Dx724/Lightfield/Artwork/Figure_1_mona_lisa.png

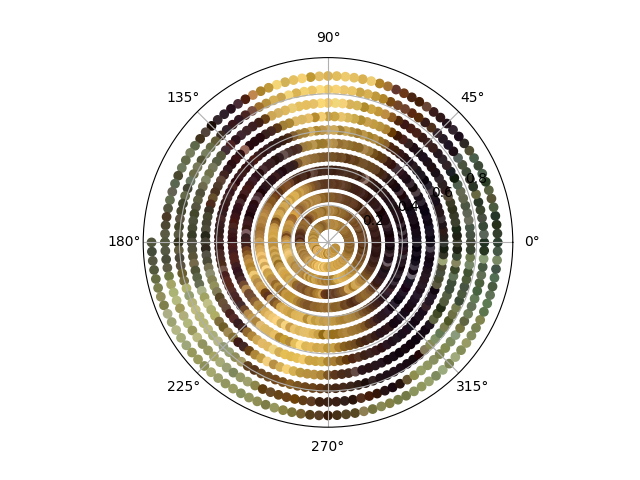
Artwork/Figure_1_mona_lisa.png
