Dx724/Lightfield/Artwork/mona_lisa.png

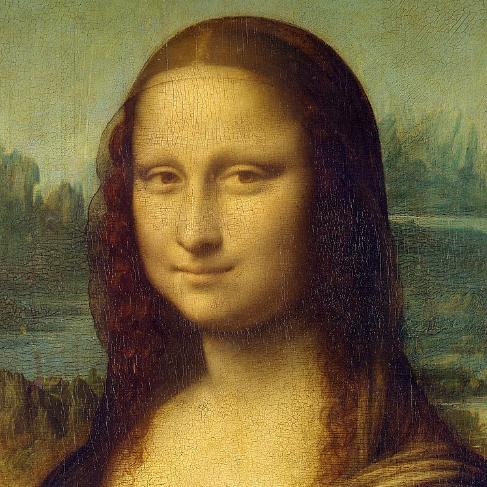
Artwork/mona_lisa.png
