Dx724/Lightfield/Artwork/The-Starry-Night.jpg

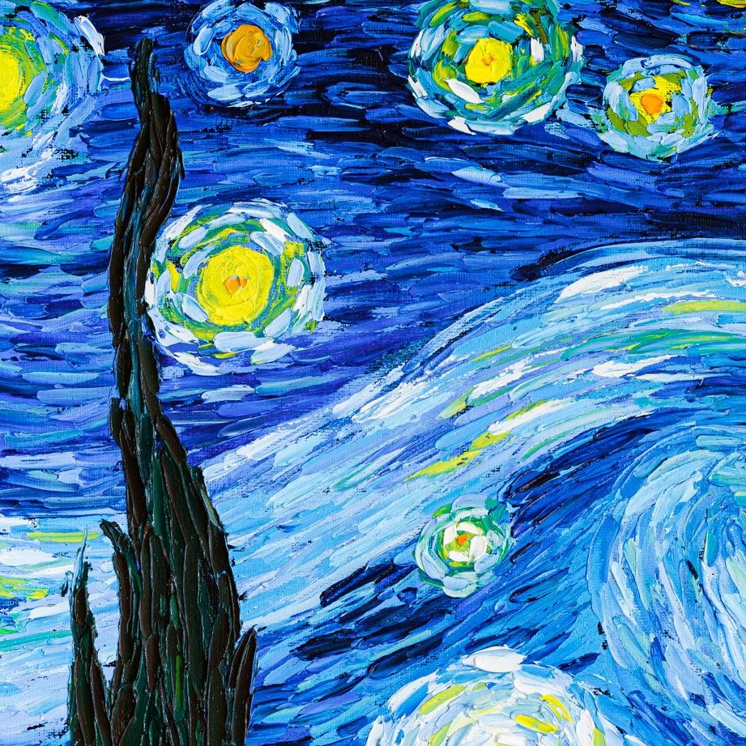
Artwork/The-Starry-Night.jpg
