Dx724/Lightfield/ESP32/Lightfield_MonaLisa.ino

#include <Stepper.h>
#include <ESP32Servo.h>

const int stepsPerRevolution = 2038;

Stepper stepper = Stepper(stepsPerRevolution, 14, 26, 27, 25);
int currentRotation = 0;

Servo servo;
const int SERVO_OFFSET = 0; // Extra degrees past 180 to point straight back to center (should be a negative or zero quantity)

const int ledPins[] = {33, 32, 2}; // R, G, B
const int pwmCh[] = {5, 6, 7};
int red = 255;
int green = 0;
int blue = 255;

double r1 = 8.89; // cm
double r2 = 9.85; // cm
double maxrad = r1 + r2 - 0.1; // cm (small tolerance provided)

void setup() {
  Serial.begin(9600);
  stepper.setSpeed(10);

  for (int i = 0; i < 3; i++) {
    ledcSetup(pwmCh[i], 1000, 8);
    ledcAttachPin(ledPins[i], pwmCh[i]);
  }

  servo.setPeriodHertz(50);
  servo.attach(15, 500, 2500); // This will find an unused PWM channel to attach to

  do_artwork();
}

void stepper_move(int steps) {
  currentRotation += steps;
  stepper.step(steps);
}

void stepper_to_angle(double angle) { // Calculated with acos, so should remain bounded
  stepper_move((int) (stepsPerRevolution*(angle/360.0) - currentRotation));
}

void combo_move(double th1, double th2) {
  stepper_to_angle(th1);
  servo.write((int) th2);
}

void setColor(byte r, byte g, byte b) {
  ledcWrite(pwmCh[0], 255 - r);
  ledcWrite(pwmCh[1], 255 - g);
  ledcWrite(pwmCh[2], 255 - b);
}

void move_to_polar(double rad, double ang) {
  rad *= maxrad;
  if (rad < r2 - r1 + 0.05) // Avoid multiple-solution issues
    return;
  if (rad == 0) // Avoid divide-by-zero issues
    rad = 0.001;
  double theta1 = acos((r1*r1+rad*rad-r2*r2)/(2*r1*rad));
  double theta2 = acos((r1*r1+r2*r2-rad*rad)/(2*r1*r2));
  theta1 *= 180.0 / PI;
  theta2 *= 180.0 / PI;
  theta1 = ang - theta1;
  theta2 = 180 + SERVO_OFFSET - theta2;
  //stepper_to_angle(theta1);
  //servo.write((int)theta2);
  combo_move(theta1, theta2);
  Serial.print(theta1);
  Serial.print("  ");
  Serial.println(theta2);
}

void led_off() {
  setColor(0, 0, 0);
}

void do_arc(double rad, double ang, byte r, byte g, byte b) {
  move_to_polar(rad, ang);
  setColor(r, g, b);
}

void do_artwork() {
  led_off();
do_arc(0.95, -180, 80, 85, 59);
do_arc(0.95, -177, 69, 76, 58);
do_arc(0.95, -174, 86, 88, 67);
do_arc(0.95, -171, 83, 89, 61);
do_arc(0.95, -168, 113, 116, 71);
do_arc(0.95, -165, 108, 111, 66);
do_arc(0.95, -162, 145, 143, 93);
do_arc(0.95, -159, 127, 127, 75);
do_arc(0.95, -156, 172, 175, 134);
do_arc(0.95, -153, 121, 128, 83);
do_arc(0.95, -150, 161, 168, 117);
do_arc(0.95, -147, 168, 172, 121);
do_arc(0.95, -144, 164, 172, 123);
do_arc(0.95, -141, 151, 152, 92);
do_arc(0.94, -138, 153, 154, 92);
do_arc(0.94, -135, 141, 144, 86);
do_arc(0.94, -132, 166, 169, 111);
do_arc(0.94, -129, 146, 153, 101);
do_arc(0.94, -126, 149, 151, 96);
do_arc(0.94, -123, 158, 159, 100);
do_arc(0.94, -120, 139, 148, 93);
do_arc(0.94, -117, 138, 141, 86);
do_arc(0.94, -114, 138, 139, 86);
do_arc(0.94, -111, 146, 145, 92);
do_arc(0.94, -108, 147, 149, 94);
do_arc(0.94, -105, 144, 139, 79);
do_arc(0.94, -102, 126, 124, 65);
do_arc(0.94, -99, 143, 135, 79);
do_arc(0.94, -96, 126, 114, 62);
do_arc(0.94, -93, 125, 113, 62);
do_arc(0.94, -90, 117, 104, 61);
do_arc(0.94, -87, 121, 114, 68);
do_arc(0.94, -84, 131, 125, 73);
do_arc(0.94, -81, 121, 110, 63);
do_arc(0.94, -78, 101, 92, 38);
do_arc(0.94, -75, 136, 140, 90);
do_arc(0.94, -72, 108, 113, 60);
do_arc(0.94, -69, 145, 149, 93);
do_arc(0.94, -66, 126, 133, 81);
do_arc(0.94, -63, 135, 144, 97);
do_arc(0.94, -60, 137, 145, 91);
do_arc(0.94, -57, 136, 144, 87);
do_arc(0.93, -54, 160, 172, 123);
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
do_arc(0.05, 45, 188, 146, 73);
do_arc(0.05, 48, 180, 138, 66);
do_arc(0.05, 51, 170, 128, 54);
do_arc(0.05, 54, 170, 128, 54);
do_arc(0.05, 57, 177, 135, 63);
}

void loop() {
  /*
  for (float i = 0.1; i < 1.0; i += 0.01) {
    move_to_polar(i, 35);
    delay(50);
  }*/
  delay(500);
}
