Dx724/Lightfield/ESP32/Lightfield/artwork.h

void do_arc(double rad, double ang, byte r, byte g, byte b);
void led_off();

void do_artwork() {
	led_off();
	do_arc(0.95, -180, 43, 118, 211);
	do_arc(0.95, -176, 1, 66, 160);
	do_arc(0.95, -172, 50, 93, 223);
	do_arc(0.95, -168, 0, 38, 139);
	do_arc(0.95, -164, 54, 99, 190);
	do_arc(0.95, -160, 0, 119, 191);
	do_arc(0.95, -156, 7, 62, 179);
	do_arc(0.95, -152, 8, 66, 176);
	do_arc(0.95, -148, 138, 199, 255);
	do_arc(0.94, -144, 14, 74, 206);
	do_arc(0.94, -140, 1, 73, 193);
	do_arc(0.94, -136, 0, 25, 99);
	do_arc(0.94, -132, 13, 64, 143);
	do_arc(0.94, -128, 6, 17, 13);
	do_arc(0.94, -124, 0, 41, 137);
	do_arc(0.94, -120, 0, 49, 161);
	do_arc(0.94, -116, 0, 31, 155);
	do_arc(0.94, -112, 229, 171, 2);
	do_arc(0.94, -108, 234, 153, 20);
	do_arc(0.94, -104, 167, 228, 255);
	do_arc(0.94, -100, 27, 49, 124);
	do_arc(0.94, -96, 0, 56, 166);
	do_arc(0.94, -92, 0, 29, 119);
	do_arc(0.94, -88, 23, 97, 230);
	do_arc(0.94, -84, 26, 76, 175);
	do_arc(0.93, -80, 23, 146, 214);
	do_arc(0.93, -76, 0, 92, 105);
	do_arc(0.93, -72, 255, 251, 58);
	do_arc(0.93, -68, 246, 229, 1);
	do_arc(0.93, -64, 0, 92, 105);
	do_arc(0.93, -60, 1, 132, 116);
	do_arc(0.93, -56, 122, 183, 230);
	do_arc(0.93, -52, 9, 85, 181);
	do_arc(0.93, -48, 27, 104, 124);
	do_arc(0.93, -44, 56, 163, 169);
	do_arc(0.93, -40, 90, 179, 213);
	do_arc(0.93, -36, 14, 72, 169);
	do_arc(0.93, -32, 60, 114, 223);
	do_arc(0.93, -28, 12, 44, 119);
	do_arc(0.93, -24, 28, 55, 126);
	do_arc(0.93, -20, 1, 58, 145);
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
	do_arc(0.05, -36, 0, 51, 131);
	do_arc(0.05, -32, 49, 97, 171);
	do_arc(0.05, -28, 32, 92, 155);
	do_arc(0.05, -24, 60, 135, 202);
	do_arc(0.05, -20, 10, 88, 160);
	do_arc(0.05, -16, 33, 110, 178);
	do_arc(0.05, -12, 147, 199, 239);
	do_arc(0.05, -8, 182, 223, 255);
}
