Dx724/Lightfield/(commit log)

2021-03-25 Add ESP32 code for two motors and RGB LED
2021-03-25 Fix servo angles
2021-03-25 Add LED brightness control
2021-03-25 README motor wiring and intro
2021-03-26 Update LED pin
